SamantazFox/AVR-FuseDoctor/README.md

AVR FuseDoctor
==============

Fuse doctor for AVR-based devices.

Enhanced version froked from https://github.com/nagaokashi/ATTiny_FuseDoctor,
that adds support for ATmegas and ATtiny2313(a)/4313.
