SamantazFox/AVR-FuseDoctor/schematics/fusedoctor.kicad_pcb

## KiCad design schematics/fusedoctor.kicad_pcb (2020-11-05)

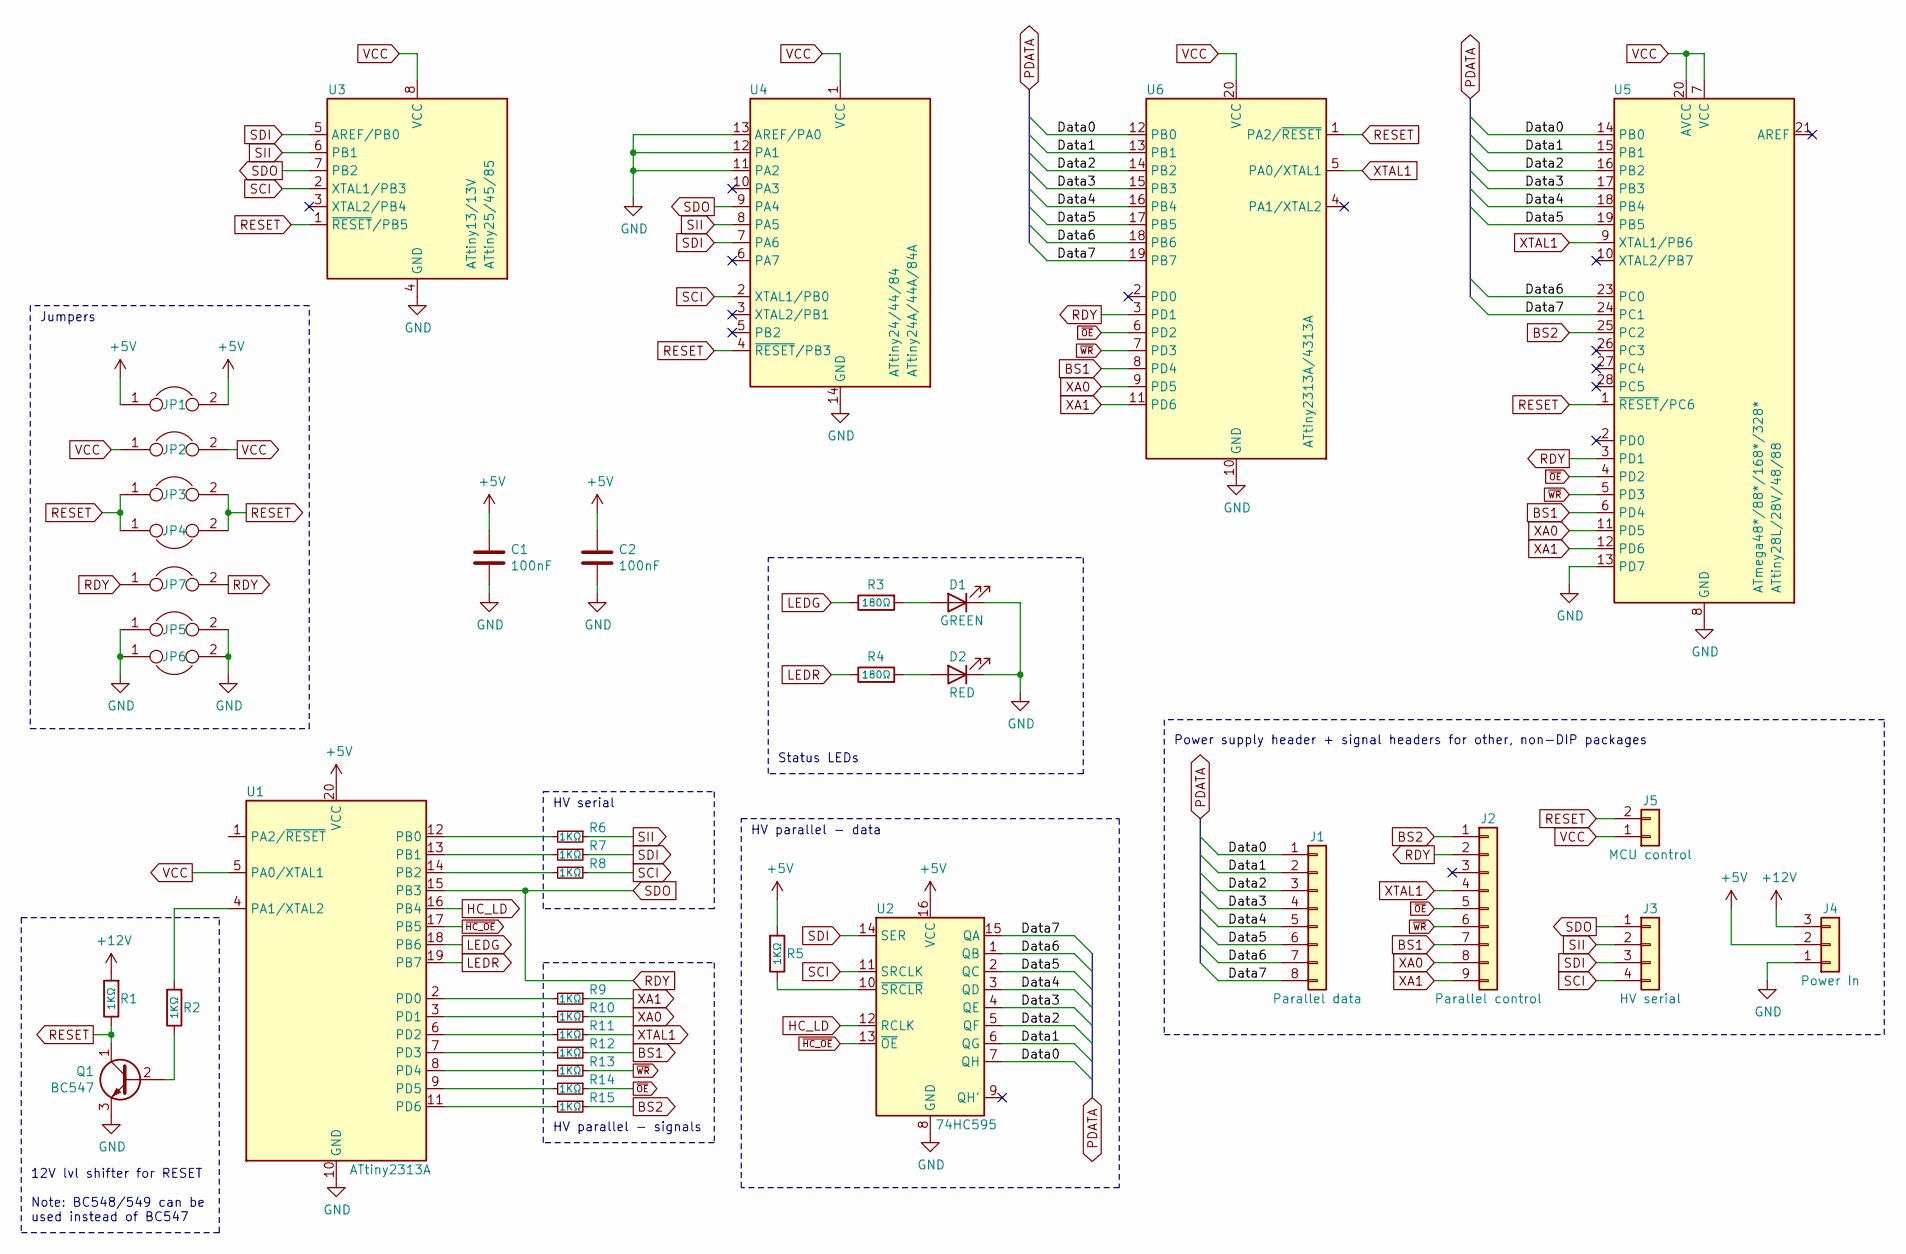
[picture p1: schematic fusedoctor.sch]

Parts:
C1, C2: 100nF; C_Axial_L3.8mm_D2.6mm_P7.50mm_Horizontal
D1: GREEN; LED_D3.0mm
D2: RED; LED_D3.0mm
J1: Parallel data; PinHeader_1x08_P2.54mm_Vertical
J2: Parallel control; PinHeader_1x09_P2.54mm_Vertical
J3: HV serial; PinHeader_1x04_P2.54mm_Vertical
J4: Power In; PinHeader_1x03_P2.54mm_Vertical
J5: MCU control; PinHeader_1x02_P2.54mm_Vertical
JP1, JP3, JP4: Jumper; R_Axial_DIN0207_L6.3mm_D2.5mm_P10.16mm_Horizontal
JP2: Jumper; R_Axial_DIN0207_L6.3mm_D2.5mm_P15.24mm_Horizontal
JP5, JP6, JP7: Jumper; R_Axial_DIN0207_L6.3mm_D2.5mm_P7.62mm_Horizontal
Q1: BC547; TO-92
R1, R2, R5, R9, R10, R11, R12, R13, R14, R15: 1KΩ; R_Axial_DIN0207_L6.3mm_D2.5mm_P7.62mm_Horizontal
R3, R4: 180Ω; R_Axial_DIN0207_L6.3mm_D2.5mm_P7.62mm_Horizontal
R6, R7, R8: 1KΩ; R_Axial_DIN0207_L6.3mm_D2.5mm_P10.16mm_Horizontal
U1: ATtiny2313A; DIP-20_W7.62mm_Socket
U2: 74HC595; DIP-16_W7.62mm_Socket
U3: ATtiny13/13V; DIP-8_W7.62mm_Socket
U4: ATtiny24/44/84; DIP-14_W7.62mm_Socket
U5: ATmega48*/88*/168*/328*; DIP-28_W7.62mm_Socket
U6: ATtiny2313A/4313A; DIP-20_W7.62mm_Socket

Connections:
+5V: C1.1, C2.1, J4.2, JP1.1, JP1.2, R5.2, U1.20 (VCC), U2.16 (VCC)
+12V: J4.3, R1.2
/Data0: J1.1, U2.7 (QH), U5.14 (PB0), U6.12 (PB0)
/Data1: J1.2, U2.6 (QG), U5.15 (PB1), U6.13 (PB1)
/Data2: J1.3, U2.5 (QF), U5.16 (PB2), U6.14 (PB2)
/Data3: J1.4, U2.4 (QE), U5.17 (PB3), U6.15 (PB3)
/Data4: J1.5, U2.3 (QD), U5.18 (PB4), U6.16 (PB4)
/Data5: J1.6, U2.2 (QC), U5.19 (PB5), U6.17 (PB5)
/Data6: J1.7, U2.1 (QB), U5.23 (PC0), U6.18 (PB6)
/Data7: J1.8, U2.15 (QA), U5.24 (PC1), U6.19 (PB7)
BS1: J2.7, R12.1, U5.6 (PD4), U6.8 (PD4)
BS2: J2.1, R15.1, U5.25 (PC2)
GND: C1.2, C2.2, D1.1 (K), D2.1 (K), J4.1, JP5.1, JP5.2, JP6.1, JP6.2, Q1.3 (E), U1.10 (GND), U2.8 (GND), U3.4 (GND), U4.11 (PA2), U4.12 (PA1), U4.13 (AREF/PA0), U4.14 (GND), U5.8 (GND), U5.13 (PD7), U5.22 (GND), U6.10 (GND)
HC_LD: U1.16 (PB4), U2.12 (RCLK)
LEDG: R3.1, U1.18 (PB6)
LEDR: R4.1, U1.19 (PB7)
unnamed: D1.2 (A), R3.2
unnamed: D2.2 (A), R4.2
unnamed: Q1.2 (B), R2.1
unnamed: R2.2, U1.4 (PA1/XTAL2)
unnamed: R5.1, U2.10 (~SRCLR)
unnamed: R6.2, U1.12 (PB0)
unnamed: R7.2, U1.13 (PB1)
unnamed: R8.2, U1.14 (PB2)
unnamed: R9.2, U1.2 (PD0)
unnamed: R10.2, U1.3 (PD1)
unnamed: R11.2, U1.6 (PD2)
unnamed: R12.2, U1.7 (PD3)
unnamed: R13.2, U1.8 (PD4)
unnamed: R14.2, U1.9 (PD5)
unnamed: R15.2, U1.11 (PD6)
RDY: J2.2, J3.1, JP7.1, JP7.2, U1.15 (PB3), U3.7 (PB2), U4.9 (PA4), U5.3 (PD1), U6.3 (PD1)
RESET: J5.2, JP3.1, JP3.2, JP4.1, JP4.2, Q1.1 (C), R1.1, U3.1 (~RESET~/PB5), U4.4 (~RESET~/PB3), U5.1 (~RESET~/PC6), U6.1 (PA2/~RESET)
SCI: J3.4, R8.1, U2.11 (SRCLK), U3.2 (XTAL1/PB3), U4.2 (XTAL1/PB0)
SDI: J3.3, R7.1, U2.14 (SER), U3.5 (AREF/PB0), U4.7 (PA6)
SII: J3.2, R6.1, U3.6 (PB1), U4.8 (PA5)
VCC: J5.1, JP2.1, JP2.2, U1.5 (PA0/XTAL1), U3.8 (VCC), U4.1 (VCC), U5.7 (VCC), U5.20 (AVCC), U6.20 (VCC)
XA0: J2.8, R10.1, U5.11 (PD5), U6.9 (PD5)
XA1: J2.9, R9.1, U5.12 (PD6), U6.11 (PD6)
XTAL1: J2.4, R11.1, U5.9 (XTAL1/PB6), U6.5 (PA0/XTAL1)
~HC_OE: U1.17 (PB5), U2.13 (~OE)
~OE: J2.5, R14.1, U5.4 (PD2), U6.6 (PD2)
~WR: J2.6, R13.1, U5.5 (PD3), U6.7 (PD3)

Notes on the sheet:
HV serial
HV parallel - signals
12V lvl shifter for RESET Note: BC548/549 can be used instead of BC547
Status LEDs
HV parallel - data
Power supply header + signal headers for other, non-DIP packages
Jumpers

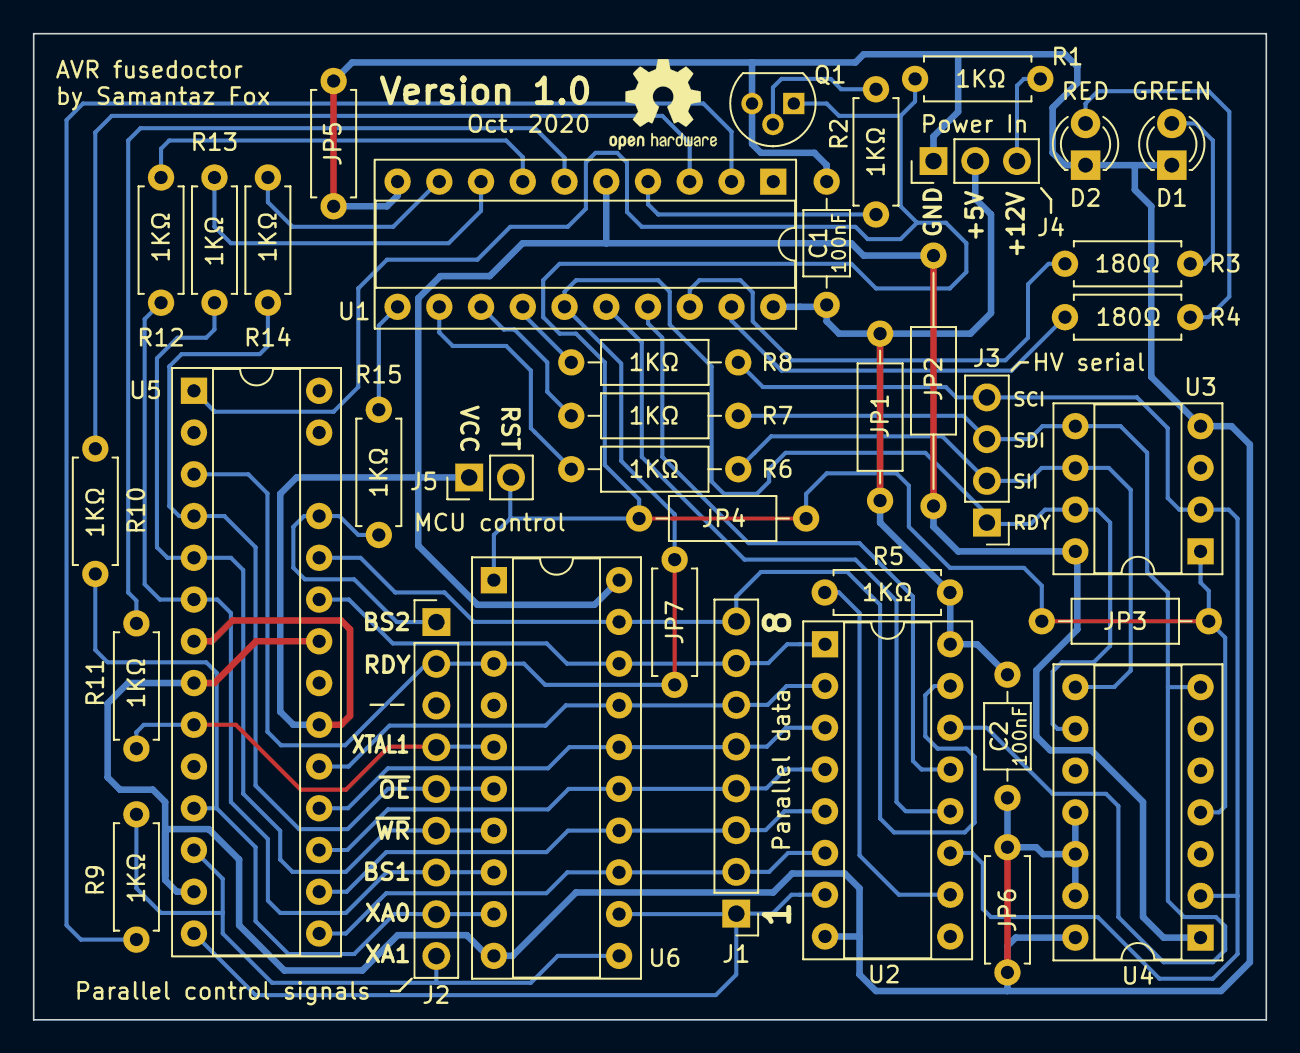
[picture p2: board fusedoctor.kicad_pcb from above]

Board: 2 copper layers, 75.0 x 60.0 mm, 38 parts (0 on the bottom side), 43 nets.
