SamantazFox/AVR-FuseDoctor/src/known_devices.c

#include "known_devices.h"


const PROGMEM known_device_t list_of_mcus[] = {
	/*
	 * ATtiny requiring HV serial programming
	*/
	{ 0x9007, 0x6A, 0xFF, 0x00, TINY_HVSERIAL },  // ATtiny13/13V

	{ 0x910B, 0x62, 0xDF, 0xFF, TINY_HVSERIAL },  // ATtiny24/24A
	{ 0x9207, 0x62, 0xDF, 0xFF, TINY_HVSERIAL },  // ATtiny44/44A
	{ 0x930C, 0x62, 0xDF, 0xFF, TINY_HVSERIAL },  // ATtiny84/84A

	{ 0x9108, 0x62, 0xDF, 0xFF, TINY_HVSERIAL },  // ATtiny25
	{ 0x9206, 0x62, 0xDF, 0xFF, TINY_HVSERIAL },  // ATtiny45
	{ 0x930B, 0x62, 0xDF, 0xFF, TINY_HVSERIAL },  // ATtiny85

	/*
	 * ATtiny requiring parallel programming
	*/
	{ 0x910A, 0x62, 0xDF, 0xFF, TINY_PARALLEL },  // ATtiny2313A
	{ 0x920D, 0x62, 0xDF, 0xFF, TINY_PARALLEL },  // ATtiny4313A

	// Warning: ATtinys 28/48/88 are pin and *protocol* compatible
	// with their ATmegas counterparts!
	// Warning 2: The ATtinys 24* only have a low fuse byte!
	{ 0x9107, 0xF4, 0x00, 0x00, MEGA_PARALLEL },  // ATtiny24L/24V
	{ 0x9209, 0x6E, 0xDF, 0xFF, MEGA_PARALLEL },  // ATtiny48
	{ 0x9311, 0x6E, 0xDF, 0xFF, MEGA_PARALLEL },  // ATtiny88

	/*
	 * ATmega requiring parallel programming
	*/
	{ 0x9403, 0xE1, 0x99, 0x00, MEGA_PARALLEL },  // ATmega16A

	{ 0x9389, 0x5E, 0xD9, 0xF4, MEGA_PARALLEL },  // ATmega8U2
	{ 0x9489, 0x5E, 0xD9, 0xF4, MEGA_PARALLEL },  // ATmega16U2
	{ 0x958A, 0x5E, 0xD9, 0xF4, MEGA_PARALLEL },  // ATmega32U2

	{ 0x9205, 0x62, 0xDF, 0xFF, MEGA_PARALLEL },  // ATmega48/48A
	{ 0x920A, 0x62, 0xDF, 0xFF, MEGA_PARALLEL },  // ATmega48PA
	{ 0x930A, 0x62, 0xDF, 0xF9, MEGA_PARALLEL },  // ATmega88/88A
	{ 0x930F, 0x62, 0xDF, 0xF9, MEGA_PARALLEL },  // ATmega88PA
	{ 0x9406, 0x62, 0xDF, 0xF9, MEGA_PARALLEL },  // ATmega168/168A
	{ 0x940B, 0x62, 0xDF, 0xF9, MEGA_PARALLEL },  // ATmega168PA
	{ 0x9514, 0x62, 0xD9, 0xFF, MEGA_PARALLEL },  // ATmega328
	{ 0x950F, 0x62, 0xD9, 0xFF, MEGA_PARALLEL },  // ATmega328P

	{ 0x9608, 0x62, 0x99, 0xFF, MEGA_PARALLEL },  // ATmega640
	{ 0x9703, 0x62, 0x99, 0xFF, MEGA_PARALLEL },  // ATmega1280
	{ 0x9704, 0x62, 0x99, 0xFF, MEGA_PARALLEL },  // ATmega1281
	{ 0x9801, 0x62, 0x99, 0xFF, MEGA_PARALLEL },  // ATmega2560
	{ 0x9802, 0x62, 0x99, 0xFF, MEGA_PARALLEL },  // ATmega2561
};


#define SIZE_LIST  sizeof(list_of_mcus)
#define SIZE_ELEM  sizeof(known_device_t)

const PROGMEM size_t mcu_list_length = (SIZE_LIST / SIZE_ELEM);
