SamantazFox/AVR-FuseDoctor/(commit log)

2020-10-16 Use standard int types instead of Arduino ones
2020-10-16 Move list of supported devices to a PROGMEM array
    Also add some new devices that will be supported in the future
2020-10-16 Get rid of Arduino's init/loop functions
2020-11-04 Add board schematics
    [fusedoctor.kicad_pcb, fusedoctor.sch]
2020-11-04 Add PCB gerbers
    [fusedoctor-B_Cu.gbr, fusedoctor-B_Mask.gbr, fusedoctor-B_SilkS.gbr, fusedoctor-Edge_Cuts.gbr, fusedoctor-F_SilkS.gbr, fusedoctor-NPTH-drl_map.gbr, fusedoctor-NPTH.drl, fusedoctor-PTH-drl_map.gbr]
2020-11-04 Update pin definitions to match schematics
2020-11-05 Add bill of materials (BOM)
    [fusedoctor.csv]
2020-11-05 Add ATtiny28L/28V/48/88 and ATmega48/88/168 to the known devices
2020-11-05 Update silkscreen on schematics
    [fusedoctor.kicad_pcb, fusedoctor.sch]
2020-11-05 Regenerate back silkscreen gerber
    [fusedoctor-B_SilkS.gbr]
